maxc0des/future-engineers-25/autonomous/motor-test.py

from motor import *

setup()

while True:
    try:
        mode = input("choose mode (motor/servo)")
        if mode == "motor":
            speed = int(input("choose speed (-255 - 255)"))
            print(type(speed))
            motor(speed)
            print("successfully set", mode, "to ", speed)
        elif mode == "servo":
            angle = int(input("choose angle (0 - 180)"))
            servo(angle)
            print("successfully set", mode, "to ", angle)
        else:
            print("invalid input")
    except KeyboardInterrupt:
        cleanup()
        print("\nstopped the test")
        break
