maxc0des/future-engineers-25/(commit log)

2024-12-14 first version of the software for the arduino
    added:
    - arduino can receive data over i2c
    -data can be translated into steering angels and speeds
2024-12-19 script to send data via i2c
    added script to send motor controle data to arduino, we have to implement logic the future
2024-12-19 comment on arduino_code.ino
2025-01-29 switched the gpio libary added motor control
2025-01-31 added motor testing script, adjusted config
2025-01-31 fixed bugs on the motor control
    [motor-test.py, motor.py]
2025-01-31 fixed a name error
    [get_data.py]
2025-02-04 quality of life fixes
    [motor.py]
2025-02-05 refactor motor control and add controller support
2025-02-28 refactor configuration structure and enhance sensor integration
2025-03-02 refactor motor and sensor control logic; enhance data collection and file handling
2025-03-10 Add asynchronous photo capture and adjust velocity scaling
2025-03-24 Add model evaluation script and improve data collection error handling
    [data-collection.py, models.py]
2025-04-07 Enhance autonomous driving logic with image difference detection and adaptive motor control
2025-04-09 Fix typo in debug print statement for predicted angle in supervised.py
    [supervised.py]
2025-04-09 Add error handling for TOF sensor and adjust motor speed in autonomous mode
    [autonomous.py, supervised.py]
2025-04-12 finaly implemented gyro sensor
2025-04-12 Add gyro reset functionality and started to implement turn logic for autonomous driving
    [get_data.py]
2025-04-14 Refactor gyro and sensor initialization logic; enhance get_gyro function to handle multiple data types and improve TOF sensor timing. Major update to turn.py
2025-04-15 Refactor turn logic to improve steering and speed control; add color detection and image masking functionality.
2025-05-05 implemented button
2025-05-05 Add backup script and modify IntegratedNN convolutional layer input channels, so we can use the gyro in the nn
2025-05-07 major fixes+advancements in autonomous driving
    [models.py, motor-test.py, motor.py]
2025-05-09 our cam broke so here is a backup for the competition tomorrow
    [get_data.py]
2025-05-09 Update model paths and adjust speed presets; increase sensor initialization delay
